shraypanwar/self-balancing-robot/cad/upper.SLDPRT

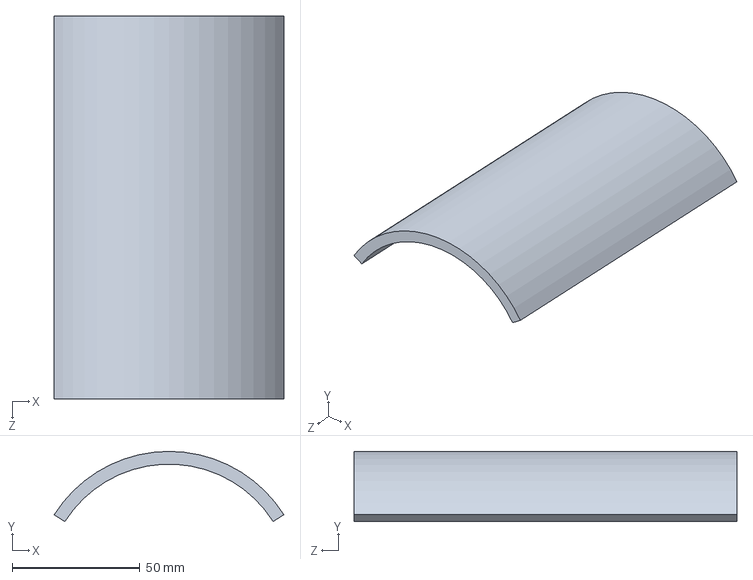
[picture p9: CAD file, 2026-10-28]
cad/upper.SLDPRT
90.0 x 27.5 x 150.0 mm
