shraypanwar/self-balancing-robot/cad/Self_balancing_robot.STEP

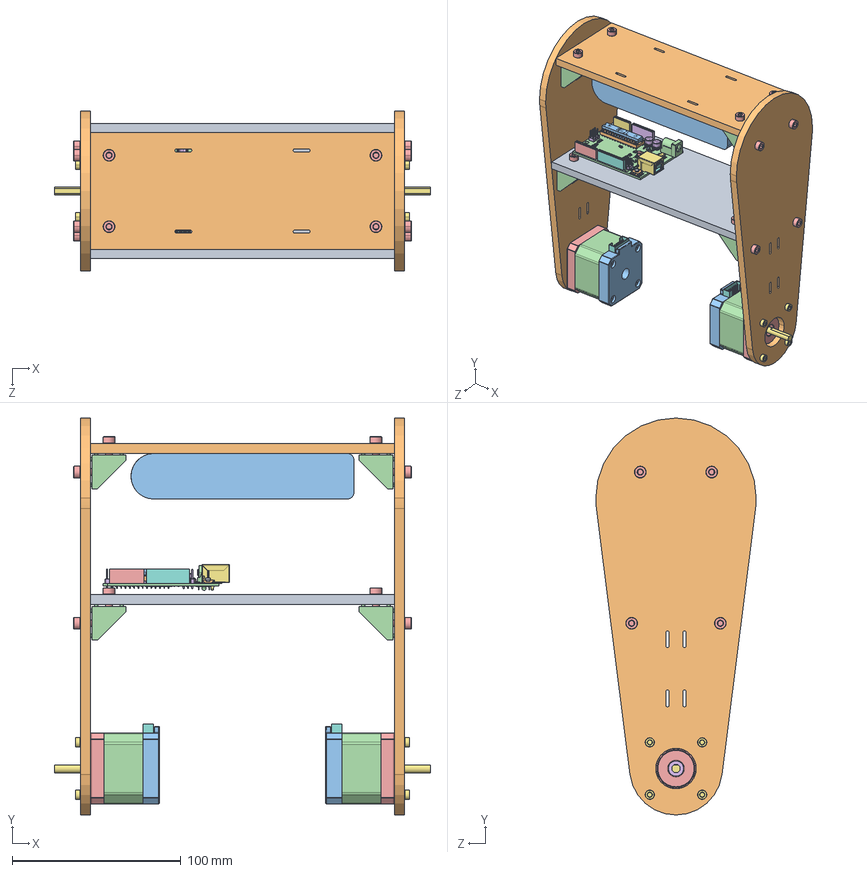
[picture p10: CAD file, 2026-10-28]
cad/Self_balancing_robot.STEP
222.7 x 235.0 x 95.0 mm
Base_Plate
Leg x 2
Nima 17 40x42x5mm x 2
Top_Plate
Battery
arduino_uno
Angle Bracket 2020 x 8
91290A306_Alloy Steel Socket Head Screw_91290A306 x 16
M4 T-Nut for 2020 extrusion_1.step x 16
91290A117_Alloy Steel Socket Head Screw_91290A117 x 8
