shraypanwar/self-balancing-robot/cad/base.SLDPRT

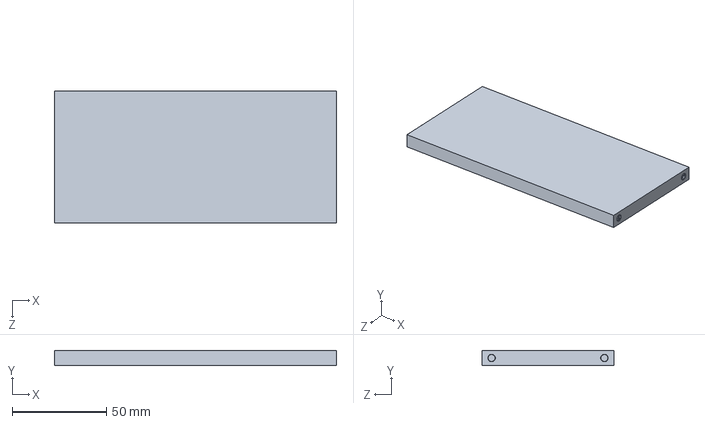
[picture p11: CAD file, 2026-10-28]
cad/base.SLDPRT
150.0 x 8.00 x 70.0 mm
