shraypanwar/self-balancing-robot/cad/sidelink.SLDPRT

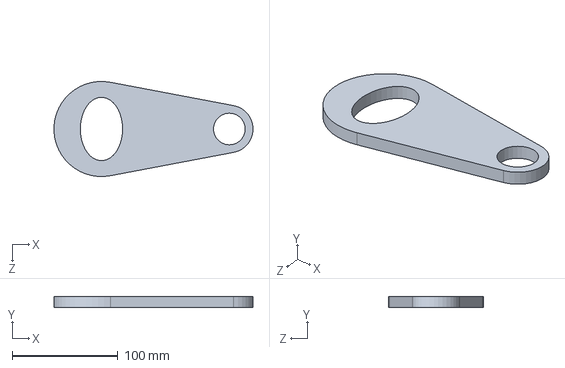
[picture p12: CAD file, 2026-10-28]
cad/sidelink.SLDPRT
188.3 x 10.0 x 89.9 mm
