shraypanwar/self-balancing-robot/cad/firstassembly.SLDASM

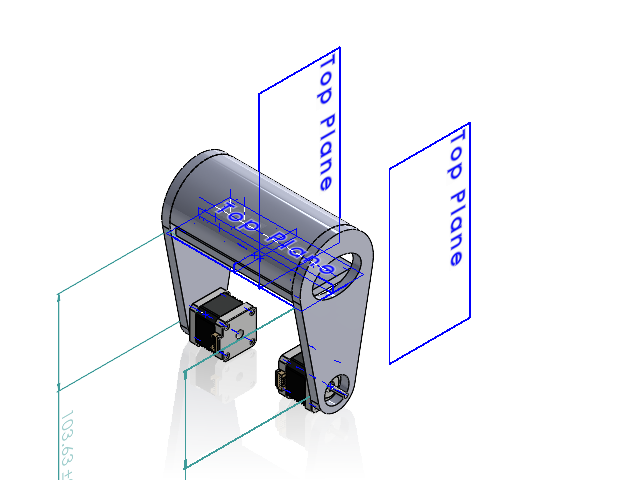
[picture p13: CAD file, 2026-10-28]
cad/firstassembly.SLDASM
base
Arduino UNO
L298N
sidelink x 2
Nima 17 40x42x5mm x 2
upperpart
